MathFerreiraDev/MP3-with-Wifi/images.h

#ifndef IMAGES_H
#define IMAGES_H

#include <pgmspace.h>  

// ═══════════════════════════════════════════════════════════════
//  TELA 1 — Player
// ═══════════════════════════════════════════════════════════════

// Disco de arte (41×40 px, RGB565)
static const uint16_t PROGMEM image_art_disc_pixels[] = {0x00, 0x7C, 0x00, 0x00, 0x00, 0x00, 0x0F, 0x84, 0x00, 0x00, 0x00, 0x00,
  0x08, 0x04, 0x00, 0x00, 0x00, 0x00, 0x08, 0x7C, 0x00, 0x00, 0x00, 0x00,
  0x0F, 0xC4, 0x00, 0x00, 0x00, 0x00, 0x08, 0x04, 0x00, 0x00, 0x00, 0x00,
  0x08, 0x04, 0x00, 0x00, 0x00, 0x00, 0x08, 0x04, 0x00, 0x00, 0x00, 0x00,
  0x08, 0x04, 0x03, 0xF8, 0x00, 0x00, 0x08, 0x38, 0x1F, 0xFF, 0x00, 0x00,
  0x70, 0x44, 0x7F, 0xFF, 0xC0, 0x00, 0x88, 0x44, 0xFC, 0x07, 0xE0, 0x00,
  0x88, 0x39, 0xF3, 0xF9, 0xF0, 0x00, 0x70, 0x03, 0xCF, 0xFE, 0x78, 0x00,
  0x00, 0x07, 0xBF, 0xFF, 0xBC, 0x00, 0x00, 0x0F, 0x7F, 0xFF, 0xDE, 0x00,
  0x00, 0x0E, 0xFF, 0xFF, 0xEE, 0x00, 0x00, 0x1E, 0xFE, 0x0F, 0xEF, 0x00,
  0x00, 0x1D, 0xFD, 0xF7, 0xF7, 0x00, 0x00, 0x1D, 0xFB, 0x1B, 0xF7, 0x00,
  0x00, 0x3B, 0xF4, 0x05, 0xFB, 0x80, 0x00, 0x3B, 0xEC, 0x06, 0xFB, 0x80,
  0x00, 0x3B, 0xE8, 0x02, 0xFB, 0x80, 0x00, 0x3B, 0xE8, 0x02, 0xFB, 0x80,
  0x00, 0x3B, 0xE8, 0x02, 0xFB, 0x80, 0x00, 0x3B, 0xEC, 0x06, 0xFB, 0x80,
  0x00, 0x3B, 0xF4, 0x05, 0xFB, 0x80, 0x00, 0x1D, 0xFB, 0x1B, 0xF7, 0x00,
  0x00, 0x1D, 0xFD, 0xF7, 0xF7, 0x00, 0x00, 0x1E, 0xFE, 0x0F, 0xEF, 0x00,
  0x00, 0x0E, 0xFF, 0xFF, 0xEE, 0x00, 0x00, 0x0F, 0x7F, 0xFF, 0xDE, 0x00,
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
  0x7B, 0x80, 0x00, 0x00, 0x00, 0x01, 0x73, 0x9D, 0x00, 0x00, 0x00, 0x00,
  0x00, 0xEF, 0xEE, 0x00, 0x00, 0x00, 0x00, 0x00, 0x5C, 0x74, 0x00, 0x00,
  0x00, 0x00, 0x00, 0x3B, 0xB8, 0x00, 0x00, 0x00, 0x00, 0x00, 0x17, 0xD0,
  0x00, 0x00, 0x00, 0x00, 0x00, 0x0E, 0xE0, 0x00, 0x00, 0x00, 0x00, 0x00,
  0x05, 0x40, 0x00, 0x00, 0x00, 0x00, 0x00, 0x03, 0x80, 0x00, 0x00, 0x00,
  0x00, 0x00, 0x01, 0x00, 0x00, 0x00, 0x00
};

#endif 
