MathFerreiraDev/MP3-with-Wifi/(commit log)

2026-07-04 Add README for MP3 Player project with ESP32
    Added detailed project description, hardware specifications, functionalities, and implementation details for the MP3 Player project using ESP32.
2026-07-05 Fix video thumbnail and update PCB version text
    Updated video thumbnail link and clarified PCB version description.
2026-07-05 Clarify player control functionalities and low power mode
    Refine descriptions for player controls and low power mode.
2026-07-07 programação necessária para o esp 32
